bkrajendra/sonpakharu/hardware/sonpakharub.png

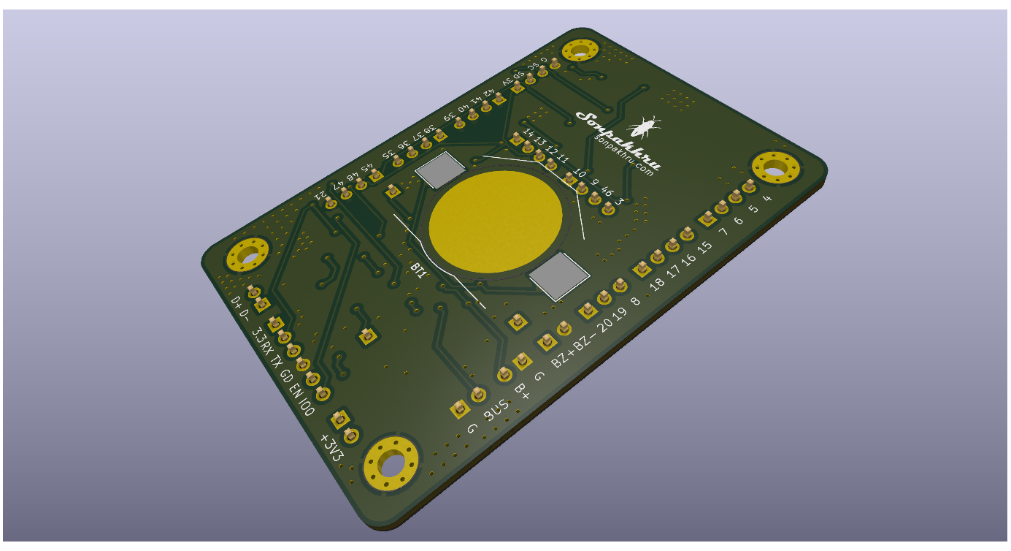
hardware/sonpakharub.png
