bkrajendra/sonpakharu/docs/sonpakharu.png

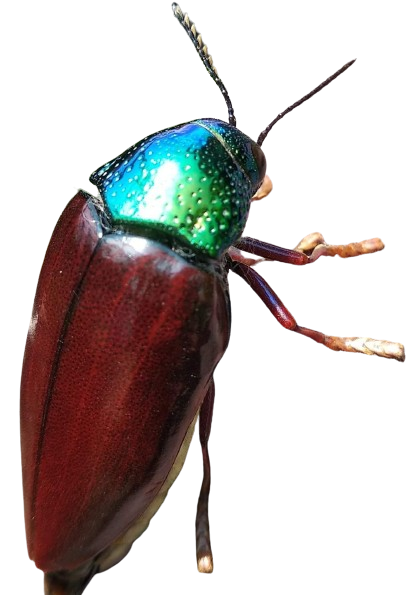
docs/sonpakharu.png
