bkrajendra/sonpakharu/docs/Water_Level_Management_SOP.docx

# Standard Operating Procedure (SOP) – Water Level Management Product

Document Version: 1.0

Date: [17/07/2025]

Purpose: To establish a standardized process for hardware and software development, integration, delivery, and support for the Water Level Management System.

# Hardware Process Flow

## 1. Component Procurement and Payment

- Identify the Bill of Materials (BOM) as per finalized circuit design.
- Source and compare prices from vendors.
- Place order and track shipments.
- Maintain procurement receipts for accounting.
- Confirm delivery checklist.

## 2. Preparation for Assembly

- Prepare and pack all required components for the assembler.
- Provide necessary documents:
- - PCB layout diagram
- - Component placement guide
- - Assembly checklist

## 3. Follow-up with Assembly

- Assign responsible person for communication with assembler.
- Monitor progress on a daily or alternate-day basis.
- Ensure proper ESD-safe practices are followed.

## 4. Validation of Assembled PCB

- Conduct visual inspection for soldering quality.
- Perform continuity and power-on checks.
- Maintain a validation checklist/log.

## 5. Programming for Specific Product

- Flash microcontroller with firmware.
- Use product-specific settings if needed (e.g., sensor calibration, ID tagging).
- Log firmware version and date.

## 6. Testing

- Conduct functional testing using predefined test cases:
- - Sensor readings
- - Communication (e.g., Wi-Fi/LoRa/GSM)
- - Power behavior
- Log results and flag errors for rework.

## 7. Delivery, Provisioning & Installation

- Prepare packaging.
- Install at customer site or deliver with installation manual.
- Configure device based on customer setup.
- Hand over device checklist.

## 8. Support

- Provide basic training to the customer (optional video/manual).
- Offer support window (e.g., 30 days free support).
- Create issue tracking document or ticket system.

# Software Process Flow

## 1. Cloud Setup

- Create cloud instance/project (AWS, GCP, etc.)
- Set up database (e.g., Firebase, MySQL), server, and dashboard.
- Maintain project credentials securely.

## 2. Integration and Testing with Product

- Ensure secure communication protocol (MQTT/HTTPS).
- Test real-time data transmission.
- Simulate multiple scenarios (no internet, power cut, etc.)

## 3. Configuration per Customer

- Setup dashboards as per customer requirements (e.g., tank name, location).
- Set alerts (SMS/email/thresholds).
- Document configuration settings.

## 4. Delivery and Installation

- Share dashboard access credentials with the customer.
- Assist with any browser/mobile setup if required.
- Provide user manual for dashboard navigation.

## 5. Support

- Provide hotline or ticket-based support system.
- Monitor uptime and health of cloud infrastructure.
- Provide monthly performance reports (optional).

# Future Standardization Notes

- Convert this into a Notion / Google Docs template for every project.
- Create checklists in task managers (ClickUp, Trello, Asana).
- Introduce QA forms for hardware and software testing.
- Create video SOPs for training new team members.
