bkrajendra/sonpakharu/hardware/sonpakharu.png

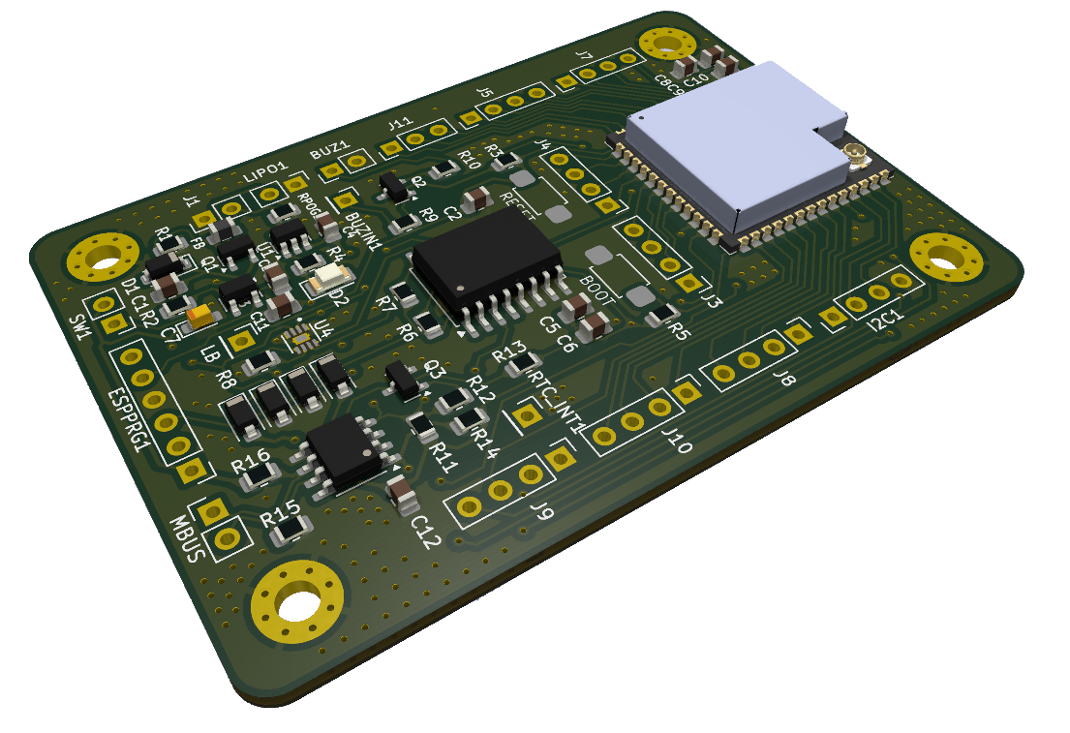
hardware/sonpakharu.png
