bkrajendra/sonpakharu/hardware/bom/bom_template_nextpcb.xls

Designator* | Quantity* | Manufacturer Part Number* | Manufacturer | Package/Footprint | Description | Procurement Type | Customer Note
C1,C2,C10,C11,C12 | 5 | CL21B105KBFNNNE |  | Capacitor_SMD:C_0805_2012Metric | 1uF
C3 | 1 | 0805B471K500NT |  | Capacitor_SMD:C_0805_2012Metric | 470pf
C4,C5 | 2 | CL21A106KAYNNNE |  | Capacitor_SMD:C_0805_2012Metric | 10uf | DNP
C6 | 1 | CC0805KRX7R9BB104 |  | Capacitor_SMD:C_0805_2012Metric | 0.1uf | C
C7 | 1 | T491A225K016AT |  | Capacitor_Tantalum_SMD:CP_EIA-2012-12_Kemet-R_Pad1.30x1.05mm_HandSolder | 2.2uf
C8,C9 | 2 | CL21A106KAYNNNE |  | Capacitor_SMD:C_0805_2012Metric | 10uF
D1,D3,D4,D5,D6 | 5 | LMBR0540T1G |  | Diode_SMD:D_SOD-123 | MBR0540
D2 | 1 | XL-3216SURC |  | LED_SMD:LED_1206_3216Metric | Charging
FB1 | 1 | BLM21PG600SN1D |  | Inductor_SMD:L_0805_2012Metric | FerriteBead
IC1 | 1 | ESP32-S3-WROOM-1U-N16R8 |  | KiCad:ESP32S3WROOM1UN4 | ESP32-S3-WROOM-1U-N4
Q1 | 1 | PMV32UP |  | Package_TO_SOT_SMD:SOT-23 | PMV32UP
Q2,Q3 | 2 | BC847B,215 |  | Package_TO_SOT_SMD:SOT-23 | BC847
R1 | 1 | 0805W8F1003T5E |  | Resistor_SMD:R_0805_2012Metric | 100K
R2 | 1 | 0805W8F0000T5E |  | Resistor_SMD:R_0805_2012Metric | 0
R3,R5,R6,R7,R8,R11,R12,R13,R14 | 9 | 0805W8F1002T5E |  | Resistor_SMD:R_0805_2012Metric | 10k
R4 | 1 | 0805W8F5101T5E |  | Resistor_SMD:R_0805_2012Metric | 5.1K
R9 | 1 | 0805W8F3901T5E |  | Resistor_SMD:R_0805_2012Metric | 3k9
R10 | 1 | 0805W8F100JT5E |  | Resistor_SMD:R_0805_2012Metric | 10E
R15,R16 | 2 | 0805W8F2002T5E |  | Resistor_SMD:R_0805_2012Metric | 20K
RPOG1 | 1 | 0805W8F1001T5E |  | Resistor_SMD:R_0805_2012Metric | 1k
U1 | 1 | MCP73831T-2ACI/OT |  | Package_TO_SOT_SMD:SOT-23-5 | MCP73831-2-OT
U2 | 1 | DS3231M+TRL |  | Package_SO:SOIC-16W_7.5x10.3mm_P1.27mm | DS3231M
U3 | 1 | MIC5219-3.3YM5-TR |  | Package_TO_SOT_SMD:SOT-23-5 | MIC5219-3.3YM5
U4 | 1 | MAX17048G+T10 |  | MAX17048G_T10:SON50P200X200X80-9N | MAX17048G_T10
U5 | 1 | MAX485ESA+T |  | Package_SO:SOIC-8_3.9x4.9mm_P1.27mm | MAX485E
