bkrajendra/sonpakharu/hardware/production/bom.csv

Designator | Footprint | Quantity | Value | LCSC Part #
BOOT1 | TACTILE SWITCH 3X4X2MM SMD | 1 | Boot
BT1 | BatteryHolder_Keystone_3002_1x2032 | 1 | Battery_Cell
BUZ1 | PinHeader_1x02_P2.54mm_Vertical | 1 | Conn_01x02
BUZIN1 | PinHeader_1x01_P2.54mm_Vertical | 1 | Conn_01x01
C1 | 0805 | 1 | 1uF | C5137578
C10, C11, C12, C2 | 0805 | 4 | 1uF | C363560
C3 | 0805 | 1 | 470pf
C4, C5 | 0805 | 2 | 10uf
C6 | 0805 | 1 | 0.1uf
C7 | CP_EIA-2012-12_Kemet-R_Pad1.30x1.05mm_HandSolder | 1 | 2.2uf
C8, C9 | 0805 | 2 | 10uF | C5137578
D1, D3, D4, D5, D6 | D_SOD-123 | 5 | MBR0540 | C116159
D2 | 1206 | 1 | Charging | C779453
ESPPRG1 | PinHeader_1x06_P2.54mm_Vertical | 1 | ESP PRG
FB | 0805 | 1 | FerriteBead
I2C1 | PinHeader_1x04_P2.54mm_Vertical | 1 | I2C
IC1 | ESP32S3WROOM1UN4 | 1 | ESP32-S3-WROOM-1U-N4 | C3013945
J1 | PinHeader_1x02_P2.54mm_Vertical | 1 | PWR
J10 | PinHeader_1x04_P2.54mm_Vertical | 1 | EXT7
J11 | PinHeader_1x03_P2.54mm_Vertical | 1 | EXT3
J3 | PinHeader_1x04_P2.54mm_Vertical | 1 | EXT4
J4 | PinHeader_1x04_P2.54mm_Vertical | 1 | EXT5
J5 | PinHeader_1x04_P2.54mm_Vertical | 1 | EXT2
J7 | PinHeader_1x04_P2.54mm_Vertical | 1 | EXT1
J8 | PinHeader_1x04_P2.54mm_Vertical | 1 | EXT8
J9 | PinHeader_1x04_P2.54mm_Vertical | 1 | EXT6
LB | PinHeader_1x01_P2.54mm_Vertical | 1 | LOWBAT
LIPO1 | PinHeader_1x02_P2.54mm_Vertical | 1 | BATT
MBUS | PinHeader_1x02_P2.54mm_Vertical | 1 | 485
Q1 | SOT-23 | 1 | PMV32UP | C96616
Q2, Q3 | SOT-23 | 2 | BC847
R1 | 0805 | 1 | 100K
R10 | 0805 | 1 | 10E
R11, R12, R13, R14, R3, R5, R6, R7, R8 | 0805 | 9 | 10k
R15, R16 | 0805 | 2 | 20K
R2 | 0805 | 1 | 0
R4 | 0805 | 1 | 5.1K
R9 | 0805 | 1 | 3k9
RESET1 | TACTILE SWITCH 3X4X2MM SMD | 1 | Reset
RPOG1 | 0805 | 1 | 1k
RTC_INT1 | PinHeader_1x01_P2.54mm_Vertical | 1 | INT
SW1 | PinHeader_1x02_P2.54mm_Vertical | 1 | ON/OFF
U1 | SOT-23-5 | 1 | MCP73831-2-OT | C424093
U2 | SOIC-16W_7.5x10.3mm_P1.27mm | 1 | DS3231M
U3 | SOT-23-5 | 1 | MIC5219-3.3YM5
U4 | SON50P200X200X80-9N | 1 | MAX17048G_T10
U5 | SOIC-8_3.9x4.9mm_P1.27mm | 1 | MAX485E | C19738
