bkrajendra/sonpakharu/hardware/production/bom.xlsx

Designator | Footprint | Quantity | Value | LCSC Part #
C1, C2, C3, C4, C5 | 805 | 5 | 10uF | C5137578
C10, C11, C6, C8 | 805 | 4 | 1uF | C363560
D1, D3, D4, D5, D6 | D_SOD-123 | 5 | MBR0540 | C116159
D2 | 1206 | 1 | orange | C779453
IC1 | ESP32S3WROOM1UN4 | 1 | ESP32-S3-WROOM-1U-N4 | C3013945
Q1 | SOT-23 | 1 | DMG3415U | C96616
Q4 | SOT-23 | 1 | S8050 | C5249674
R1, R2 | 805 | 2 | 100K | C25803
R10, R13 | 805 | 2 | 20K | C25804
R12, R14, R15, R16, R5, R7, R8, R9 | 805 | 8 | 10K | C25804
R3, R4 | 805 | 2 | 5.1K | C23186
Reset1 | tactile_5.4 | 1 | Reset
U1 | SOT25 | 1 | AP2112K-3.3TRG1 | C51118
U2 | SOT-23-5 | 1 | MCP73831-2-OT | C424093
U3 | SOIC-8_3.9x4.9mm_P1.27mm | 1 | MCP3426Axx-xSN
U4 | SOIC-8_3.9x4.9mm_P1.27mm | 1 | MAX485E | C19738
