bkrajendra/sonpakharu/hardware/sonpakharu.step

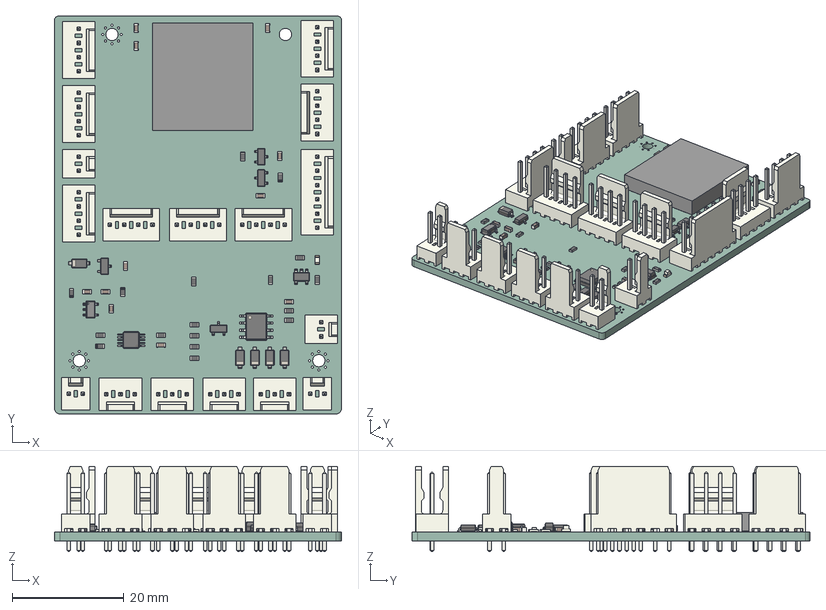
[picture p4: CAD file, 2024-04-07]
hardware/sonpakharu.step
51.3 x 71.1 x 15.3 mm
Molex_AE_6410_02A x 4
D_SOD_123 x 5
Molex_AE_6410_04A x 8
C_0603_1608Metric x 11
SOT_23 x 4
SOIC_8_39x49mm_P127mm
R_0603_1608Metric x 17
Molex_AE_6410_03A x 4
ASSEMBLY
AP2112K-3.3TRG1
VSSOP_10_3x3mm_P05mm
Molex_AE_6410_06A
SOT_23_5
LED_0603_1608Metric
sonpakharu_PCB
