bkrajendra/sonpakharu/docs/best-schematic.pdf

# 3.3V KMR²

# GNDRED

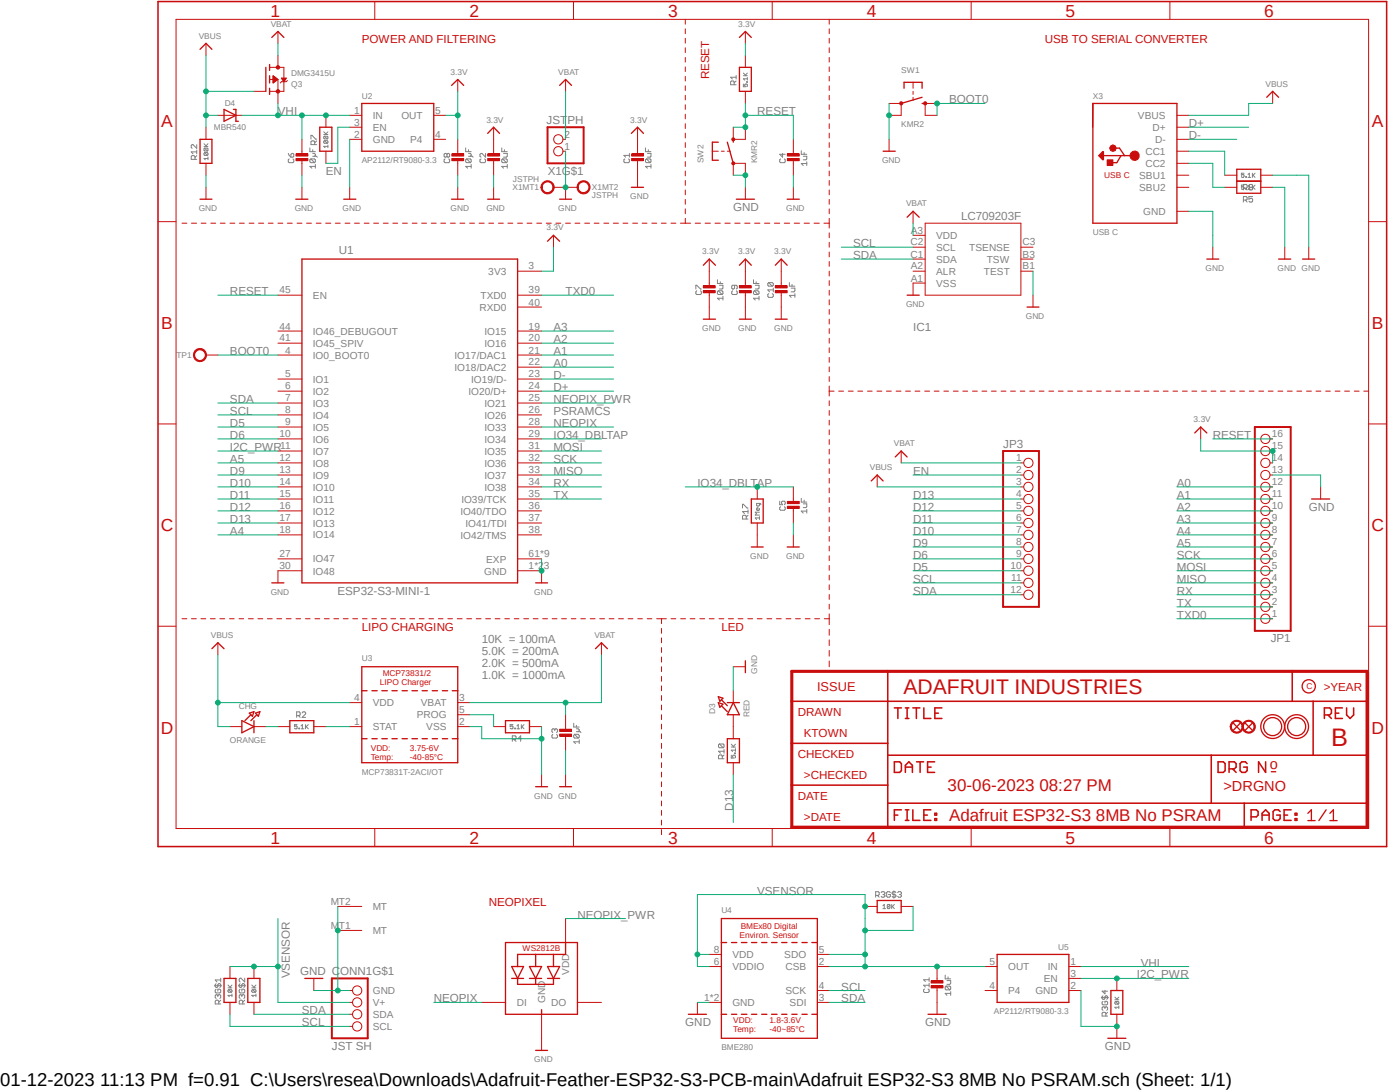
[picture p5: page 1]

VBAT

01-12-2023 11:13 PM f=0.91 C:\Users\resea\Downloads\Adafruit-Feather-ESP32-S3-PCB-main\Adafruit ESP32-S3 8MB No PSRAM.sch (Sheet: 1/1)
