bkrajendra/sonpakharu/docs/schematic.pdf

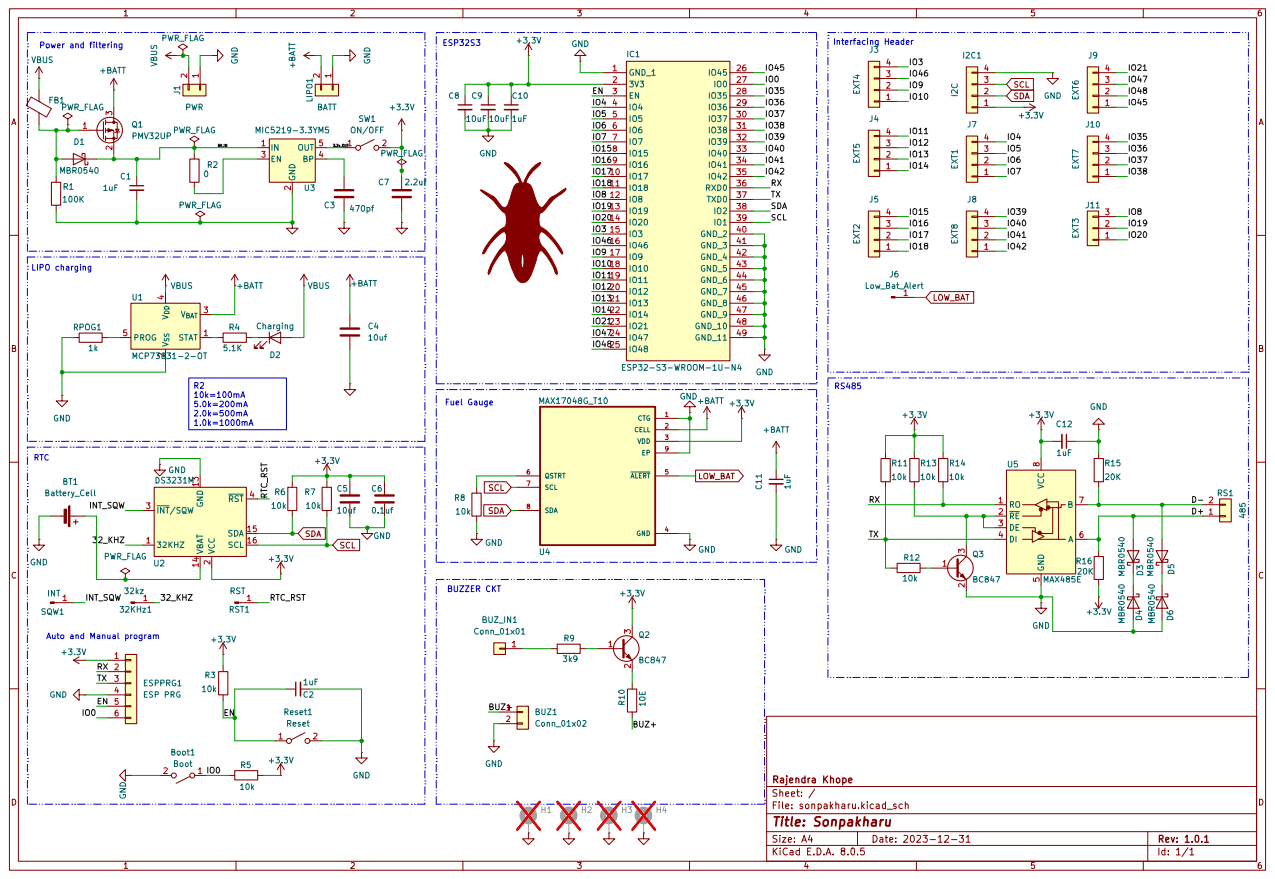
[picture p6: page 1]
