bkrajendra/sonpakharu/hardware/sonpakharu.kicad_pcb

## KiCad design hardware/sonpakharu.kicad_pcb (2025-07-19)

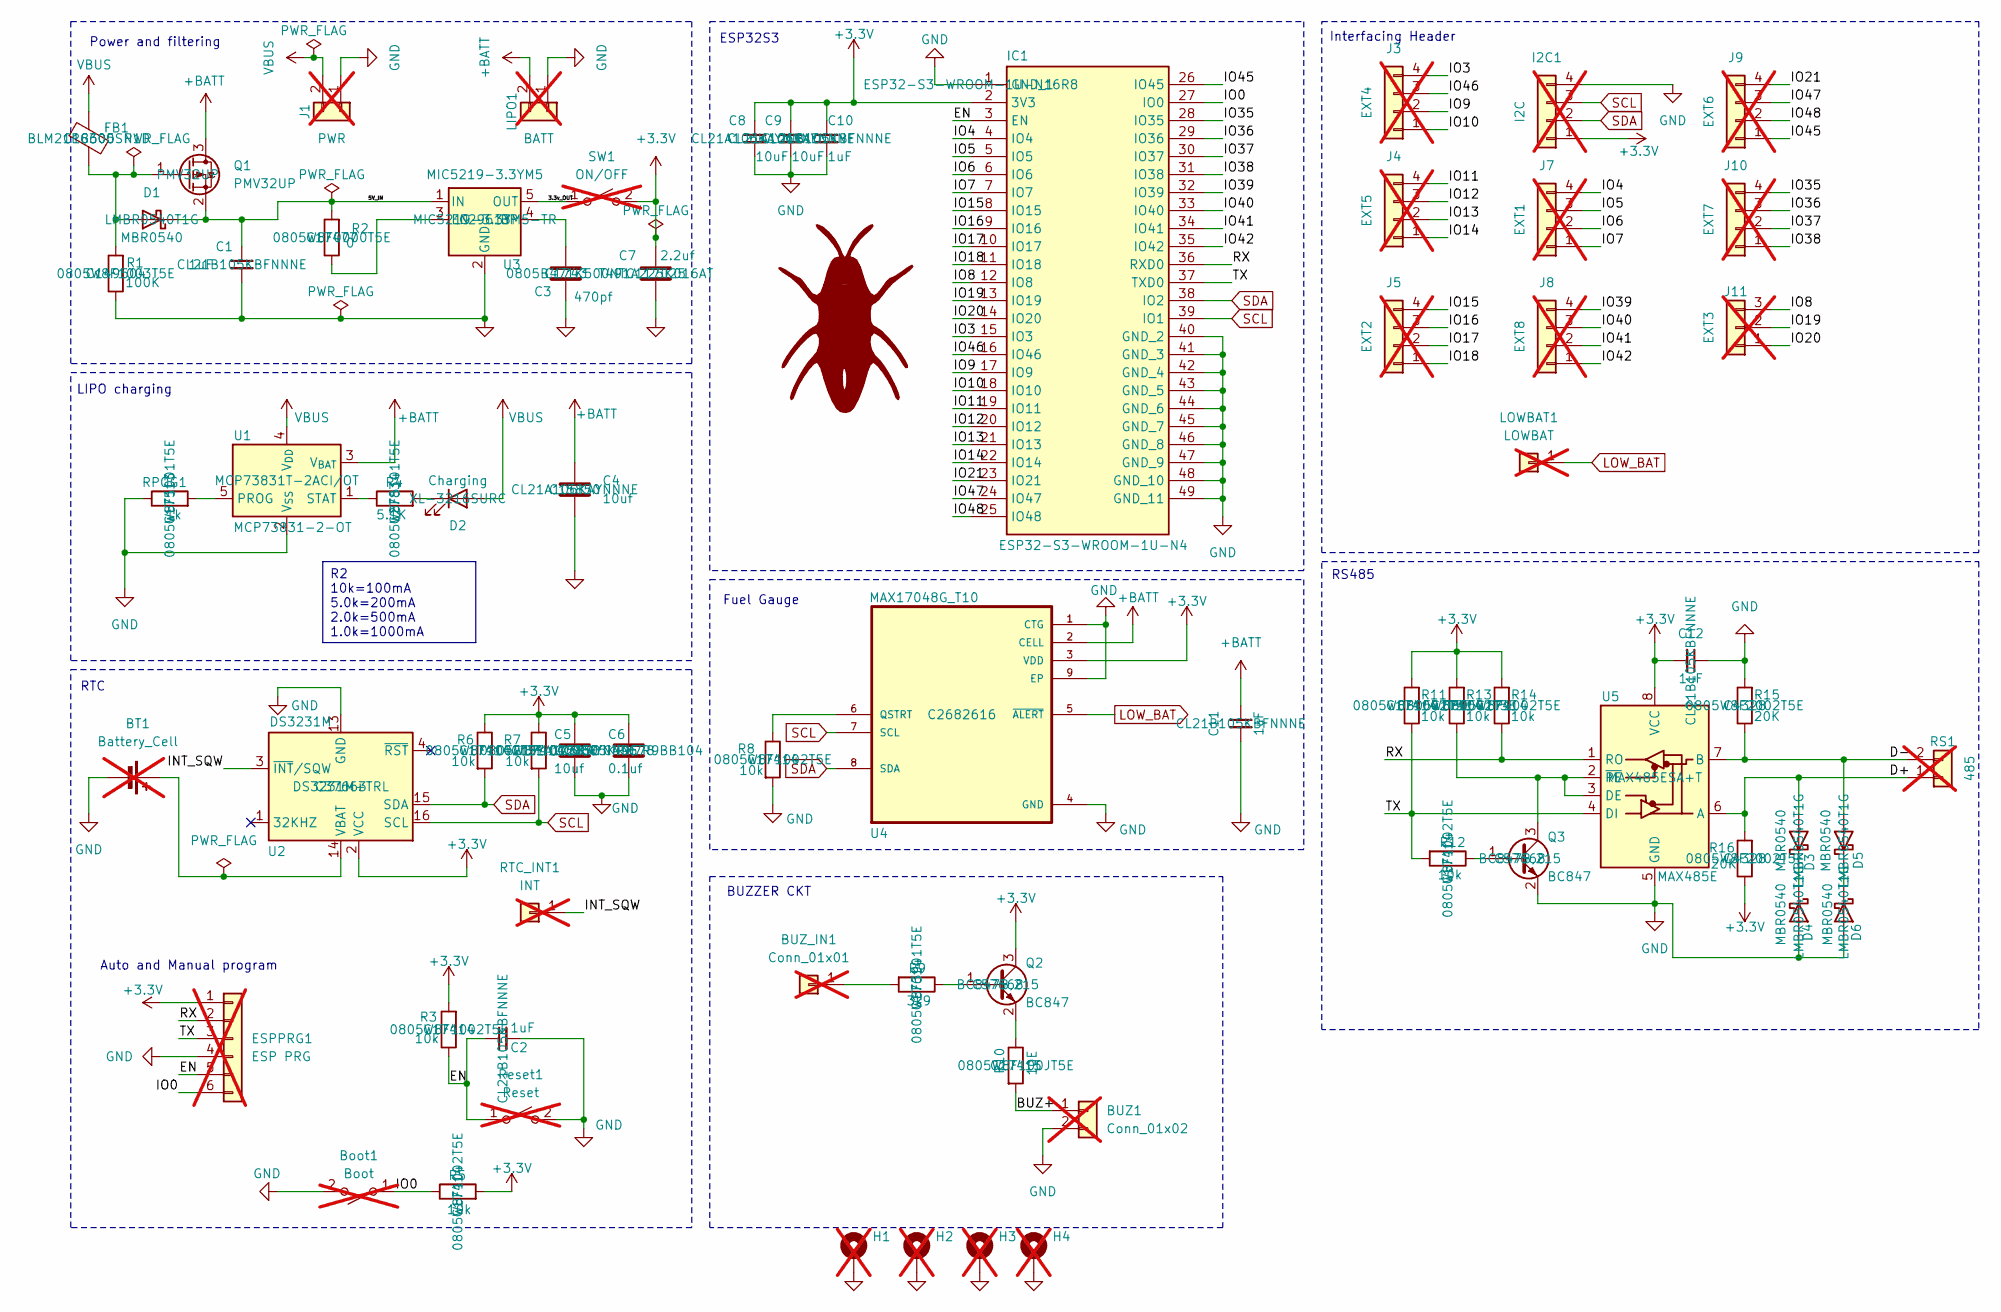
[picture p7: schematic sonpakharu.kicad_sch]

Parts:
BT1: Battery_Cell; BatteryHolder_Keystone_3002_1x2032; not fitted
BUZ1: Conn_01x02; PinHeader_1x02_P2.54mm_Vertical; not fitted
BUZ_IN1: Conn_01x01; PinHeader_1x01_P2.54mm_Vertical; not fitted
Boot1: Boot; TACTILE SWITCH 3X4X2MM SMD; not fitted
C1, C2, C10, C11, C12: 1uF; C_0805_2012Metric; MPN C28323
C3: 470pf; C_0805_2012Metric; MPN C1743
C4, C5: 10uf; C_0805_2012Metric; MPN C15850
C6: 0.1uf; C_0805_2012Metric; MPN C49678
C7: 2.2uf; CP_EIA-2012-12_Kemet-R_Pad1.30x1.05mm_HandSolder; MPN C117025
C8, C9: 10uF; C_0805_2012Metric; MPN C15850
D1, D3, D4, D5, D6: MBR0540; D_SOD-123; MPN C78545
D2: Charging; LED_1206_3216Metric; MPN C965822
ESPPRG1: ESP PRG; PinHeader_1x06_P2.54mm_Vertical; not fitted
FB1: FerriteBead; L_0805_2012Metric; MPN C18305
H1, H2, H4: MountingHole_Pad; MountingHole_3mm_Pad_Via; not fitted
H3: mounting hole; MountingHole_3mm_Pad_Via; not fitted
I2C1: I2C; PinHeader_1x04_P2.54mm_Vertical; not fitted
IC1: ESP32-S3-WROOM-1U-N4; ESP32S3WROOM1UN4; Manufacturer_Part_Number ESP32-S3-WROOM-1U-N4; Mouser Part Number 356-ESP32S3WROOM1UN4
J1: PWR; PinHeader_1x02_P2.54mm_Vertical; not fitted
J3: EXT4; PinHeader_1x04_P2.54mm_Vertical; not fitted
J4: EXT5; PinHeader_1x04_P2.54mm_Vertical; not fitted
J5: EXT2; PinHeader_1x04_P2.54mm_Vertical; not fitted
J7: EXT1; PinHeader_1x04_P2.54mm_Vertical; not fitted
J8: EXT8; PinHeader_1x04_P2.54mm_Vertical; not fitted
J9: EXT6; PinHeader_1x04_P2.54mm_Vertical; not fitted
J10: EXT7; PinHeader_1x04_P2.54mm_Vertical; not fitted
J11: EXT3; PinHeader_1x03_P2.54mm_Vertical; not fitted
LIPO1: BATT; PinHeader_1x02_P2.54mm_Vertical; not fitted
LOWBAT1: LOWBAT; PinHeader_1x01_P2.54mm_Vertical; not fitted
Q1: PMV32UP; SOT-23; MPN C2959851
Q2, Q3: BC847; SOT-23; MPN C57668
R1: 100K; R_0805_2012Metric; MPN C149504
R2: 0; R_0805_2012Metric; MPN C17477
R3, R5, R6, R7, R8, R11, R12, R13, R14: 10k; R_0805_2012Metric; MPN C17414
R4: 5.1K; R_0805_2012Metric; MPN C27834
R9: 3k9; R_0805_2012Metric; MPN C17614
R10: 10E; R_0805_2012Metric; MPN C17415
R15, R16: 20K; R_0805_2012Metric; MPN C4328
RPOG1: 1k; R_0805_2012Metric; MPN C17513
RS1: 485; PinHeader_1x02_P2.54mm_Vertical; not fitted
RTC_INT1: INT; PinHeader_1x01_P2.54mm_Vertical; not fitted
Reset1: Reset; TACTILE SWITCH 3X4X2MM SMD; not fitted
SW1: ON/OFF; PinHeader_1x02_P2.54mm_Vertical; not fitted
U1: MCP73831-2-OT; SOT-23-5; MPN C424093
U2: DS3231M; SOIC-16W_7.5x10.3mm_P1.27mm; MPN C37663
U3: MIC5219-3.3YM5; SOT-23-5; MPN C29613
U4: MAX17048G_T10; SON50P200X200X80-9N; MPN C2682616
U5: MAX485E; SOIC-8_3.9x4.9mm_P1.27mm; MPN C19738

Connections:
+3.3V: C5.1, C6.1, C7.1, C8.1, C9.1, C10.1, C12.2, ESPPRG1.1, I2C1.1, IC1.2 (3V3), Q2.3 (C), R3.2, R5.2, R6.1, R7.1, R11.2, R13.2, R14.2, R16.1, SW1.2 (B), U2.2 (VCC), U4.3 (VDD), U5.8 (VCC)
+BATT: C4.1, C11.1, LIPO1.2, Q1.3 (D), U1.3 (V_{BAT}), U4.2 (CELL)
/3.3v_OUT: SW1.1 (A), U3.5 (OUT)
/5V_IN: C1.1, D1.1 (K), Q1.2 (S), R2.2, U3.1 (IN)
/BUZ+: BUZ1.1, R10.2
/D+: D3.2 (A), R16.2, RS1.1, U5.6 (A); also elsewhere on the board
/D-: D5.2 (A), R15.1, RS1.2, U5.7 (B); also elsewhere on the board
/EN: C2.1, ESPPRG1.5, IC1.3 (EN), R3.1, Reset1.1 (A)
/INT_SQW: RTC_INT1.1, U2.3 (~INT/SQW)
/IO0: Boot1.1 (A), ESPPRG1.6, IC1.27 (IO0), R5.1
/IO3: IC1.15 (IO3), J3.4
/IO4: IC1.4 (IO4), J7.4
/IO5: IC1.5 (IO5), J7.3
/IO6: IC1.6 (IO6), J7.2
/IO7: IC1.7 (IO7), J7.1
/IO8: IC1.12 (IO8), J11.3
/IO9: IC1.17 (IO9), J3.2
/IO10: IC1.18 (IO10), J3.1
/IO11: IC1.19 (IO11), J4.4
/IO12: IC1.20 (IO12), J4.3
/IO13: IC1.21 (IO13), J4.2
/IO14: IC1.22 (IO14), J4.1
/IO15: IC1.8 (IO15), J5.4
/IO16: IC1.9 (IO16), J5.3
/IO17: IC1.10 (IO17), J5.2
/IO18: IC1.11 (IO18), J5.1
/IO19: IC1.13 (IO19), J11.2
/IO20: IC1.14 (IO20), J11.1
/IO21: IC1.23 (IO21), J9.4
/IO35: IC1.28 (IO35), J10.4
/IO36: IC1.29 (IO36), J10.3
/IO37: IC1.30 (IO37), J10.2
/IO38: IC1.31 (IO38), J10.1
/IO39: IC1.32 (IO39), J8.4
/IO40: IC1.33 (IO40), J8.3
/IO41: IC1.34 (IO41), J8.2
/IO42: IC1.35 (IO42), J8.1
/IO45: IC1.26 (IO45), J9.1
/IO46: IC1.16 (IO46), J3.3
/IO47: IC1.24 (IO47), J9.3
/IO48: IC1.25 (IO48), J9.2
/RX: ESPPRG1.2, IC1.36 (RXD0), R14.1, U5.1 (RO)
/TX: ESPPRG1.3, IC1.37 (TXD0), R11.1, R12.2, U5.4 (DI)
GND: BT1.2 (-), BUZ1.2, Boot1.2 (B), C1.2, C2.2, C3.2, C4.2, C5.2, C6.2, C7.2, C8.2, C9.2, C10.2, C11.2, C12.1, D4.2 (A), D6.2 (A), ESPPRG1.4, H1.1, H2.1, H3.1, H4.1, I2C1.4, IC1.1 (GND_1), IC1.40 (GND_2), IC1.41 (GND_3), IC1.42 (GND_4), IC1.43 (GND_5), IC1.44 (GND_6), IC1.45 (GND_7), IC1.46 (GND_8), IC1.47 (GND_9), IC1.48 (GND_10), IC1.49 (GND_11), J1.1, LIPO1.1, Q3.2 (E), R1.1, R8.2, R15.2, RPOG1.1, Reset1.2 (B), U1.2 (V_{SS}), U2.5 (GND), U2.6 (GND), U2.7 (GND), U2.8 (GND), U2.9 (GND), U2.10 (GND), U2.11 (GND), U2.12 (GND), U2.13 (GND), U3.2 (GND), U4.1 (CTG), U4.4 (GND), U4.9 (EP), U5.5 (GND)
LOW_BAT: LOWBAT1.1, U4.5 (~ALERT); also elsewhere on the board
unnamed: BT1.1 (+), U2.14 (VBAT)
unnamed 46: BUZ_IN1.1, R9.2; also elsewhere on the board
unnamed 47: D1.2 (A), FB1.2, Q1.1 (G), R1.2; also elsewhere on the board
unnamed: D2.1 (K), R4.2
unnamed: D3.1 (K), D4.1 (K)
unnamed: D5.1 (K), D6.1 (K)
unnamed: Q2.1 (B), R9.1
unnamed: Q2.2 (E), R10.1
unnamed: Q3.1 (B), R12.1
unnamed: Q3.3 (C), R13.1, U5.2 (~RE), U5.3 (DE)
unnamed: RPOG1.2, U1.5 (PROG)
unnamed: R4.1, U1.1 (STAT)
unnamed: C3.1, U3.4 (BP)
unnamed: R2.1, U3.3 (EN)
unnamed: R8.1, U4.6 (QSTRT)
SCL: I2C1.3, IC1.39 (IO1), R7.2, U2.16 (SCL), U4.7 (SCL)
SDA: I2C1.2, IC1.38 (IO2), R6.2, U2.15 (SDA), U4.8 (SDA)
VBUS: D2.2 (A), FB1.1, J1.2, U1.4 (V_{DD}); also elsewhere on the board

Notes on the sheet:
Power and filtering
BUZZER CKT
Auto and Manual program
Fuel Gauge
RS485
RTC
LIPO charging
ESP32S3
Interfacing Header
R2 10k=100mA 5.0k=200mA 2.0k=500mA 1.0k=1000mA

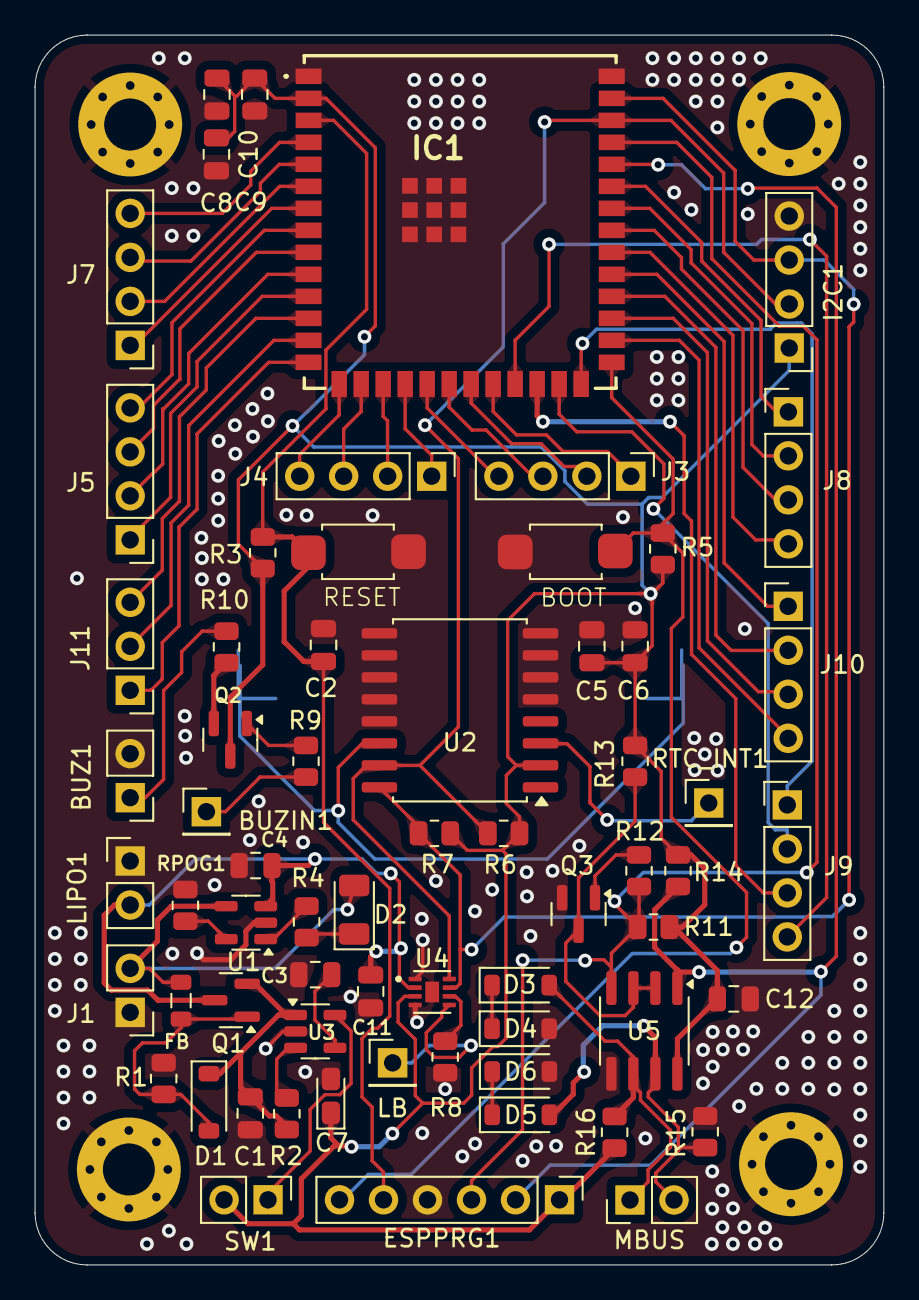
[picture p8: board sonpakharu.kicad_pcb from above]

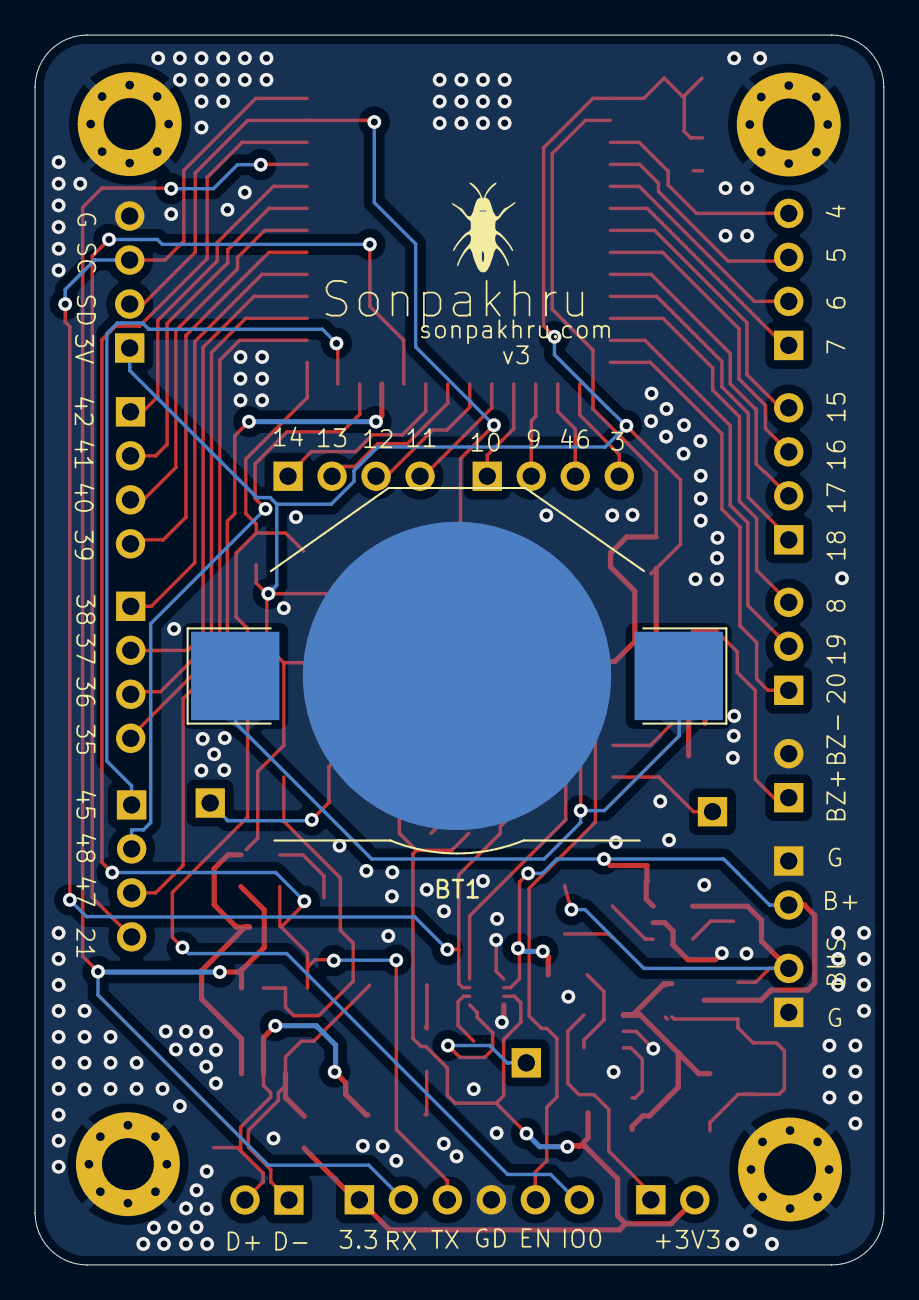
[picture p9: board sonpakharu.kicad_pcb from below]

Board: 2 copper layers, 49.0 x 71.0 mm, 71 parts (2 on the bottom side), 63 nets.

Other parts of the board:
BUZIN1: Conn_01x01; PinHeader_1x01_P2.54mm_Vertical
FB: FerriteBead; L_0805_2012Metric
LB: LOWBAT; PinHeader_1x01_P2.54mm_Vertical
MBUS: 485; PinHeader_1x02_P2.54mm_Vertical
spb: LOGO; sonpakaharu

Their connections:
/D+: MBUS.1; also elsewhere on the board
/D-: MBUS.2; also elsewhere on the board
LOW_BAT: LB.1; also elsewhere on the board
unnamed 46: BUZIN1.1; also elsewhere on the board
unnamed 47: FB.2; also elsewhere on the board
VBUS: FB.1; also elsewhere on the board
