bkrajendra/sonpakharu/(threads)

Thread 1 (2024-04-07):

Missing Power Switch

bkrajendra, 2024-04-07:
The board do not have a power on off switch
It needs one switch for the last power input to switch ON-OFF battery or supply power off.
Need just a pad, and the switch will be mounted on the case.

gauravbhand85, 2024-04-07:
added switch and normal pin header footprint

gauravbhand85, 2024-04-10:
created custom footprint for the ordered switch. Only needs to verify physically now.

bkrajendra, 2024-08-11:
added header

Closed 2024-08-11.

Thread 2 (2024-04-07):

Board pin map is incorrect.

bkrajendra, 2024-04-07:
Map the board pins correctly
http://wiki.fluidnc.com/en/hardware/ESP32-S3_Pin_Reference
refer: https://docs.espressif.com/projects/esp-idf/en/stable/esp32s3/api-reference/peripherals/gpio.html
https://www.espressif.com/sites/default/files/documentation/esp32-s3_technical_reference_manual_en.pdf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

gauravbhand85, 2024-04-10:
this has been figured out now

gauravbhand85, 2024-04-10:
corrected

Closed 2024-08-11.

Thread 5 (2024-08-11):

Add RTC module on board with battery holder

bkrajendra, 2024-08-11:
Add RTC module on board with battery holder
Suggest RTC chip
DS3231 or DS1307

bkrajendra, 2024-08-11:
https://arduinogetstarted.com/faq/ds3231-vs-ds1307

bkrajendra, 2024-09-02:
done

Closed 2024-09-02.

Thread 6 (2024-08-11):

add buzzer on main board

bkrajendra, 2024-08-11:
add buzzer on main board
3v buzzer - passive.

Thread 8 (2024-09-02):

Arrange pins for shortest path with esp32

bkrajendra, 2024-09-02:
Arrange pins for shortest path with esp32
