bkrajendra/sonpakharu/(commit log)

2023-12-01 Added s3 footprint
    [sonpakharu.kicad_pcb, sonpakharu.kicad_sch]
2023-12-01 Fixed paths
    [sonpakharu.kicad_pcb, sonpakharu.kicad_sch]
2023-12-02 added usb otg
    [sonpakharu.kicad_sch]
2023-12-02 added uart,reset
    [sonpakharu.kicad_sch]
2023-12-02 minor changes
    [sonpakharu.kicad_sch]
2023-12-02 added power and program ckt
    [sonpakharu.kicad_sch]
2023-12-02 added adc
    [sonpakharu.kicad_sch]
2023-12-02 added gpio connectors
    [sonpakharu.kicad_sch]
2023-12-02 added battery connector
    [sonpakharu.kicad_sch]
2023-12-02 main power
    [sonpakharu.kicad_sch]
2023-12-02 khope ka kida
    [sonpakharu.kicad_sch]
2023-12-02 minor change
    [sonpakharu.kicad_sch]
2023-12-03 added main components mpn
    [sonpakharu.kicad_sch]
2024-01-01 Fix: routing
    [bom.csv, designators.csv, positions.csv, sonpakharu.csv, sonpakharu.kicad_pcb, sonpakharu.kicad_sch]
2024-01-01 routing done
    [bom.csv, designators.csv, positions.csv, sonpakharu.kicad_pcb]
2024-01-02 added 485
    [sonpakharu.kicad_sch]
2024-01-02 converted 485 sch to pcb
    [sonpakharu.kicad_pcb]
2024-01-02 component placment done
    [freerouting.dsn, sonpakharu.kicad_pcb, sonpakharu.kicad_sch]
2024-01-02 all routing done, no errors, 3 minor warnings
    [freerouting.dsn, sonpakharu.kicad_pcb]
2024-01-02 corrected placement
    [freerouting.dsn, sonpakharu.kicad_pcb, temp-freerouting.dsn]
2024-01-02 track correction and tactile switch footprint pending
    [sonpakharu.kicad_pcb]
2024-01-03 almost all tracks corrected, added tactile smd
    [sonpakharu.kicad_pcb, sonpakharu.kicad_sch]
2024-01-03 all tracks corrected, 0 errors 0 warnings
    [sonpakharu.kicad_pcb]
2024-01-03 Added: labels
    [bom.csv, designators.csv, freerouting.dsn, positions.csv, sonpakharu.kicad_pcb, temp-freerouting.dsn]
2024-01-03 completed all labels, added mx485 mpn
    [sonpakharu.kicad_pcb, sonpakharu.kicad_sch]
2024-01-03 corrected labels
    [sonpakharu.kicad_pcb]
2024-01-04 added holes
    [sonpakharu.kicad_pcb]
2024-01-07 Fix: added pads, ground vias and logo
    [bom.csv, designators.csv, positions.csv, sonpakharu.kicad_pcb, sonpakharu.kicad_sch]
2024-01-08 updated tactile smd part number
    [bom.csv, designators.csv, positions.csv, sonpakharu.kicad_pcb, sonpakharu.kicad_sch]
2024-02-04 Fix: foot prints, re routed pcb, added 3d model
    [bom.csv, designators.csv, freerouting.dsn, positions.csv, sonpakharu.kicad_pcb, sonpakharu.kicad_sch, temp-freerouting.dsn]
2024-04-07 Fix: final fixes
    [bom.csv, designators.csv, positions.csv, sonpakharu.kicad_pcb, sonpakharu.kicad_sch, sonpakharu.step, sonpakhru.csv, sonpakhru.kicad_pcb]
2024-04-07 Fix cleanup
    [bom.csv, designators.csv, positions.csv, sonpakhru.csv, sonpakhru.kicad_pcb, sonpakhru.kicad_sch]
2024-04-15 rectified sch
    [sonpakharu.kicad_pcb, sonpakharu.kicad_sch]
2024-04-23 deleted unused footprints
    [sonpakharu.kicad_pcb]
2024-05-12 removed auto prg ckt, done routing, touch up pending
    [sonpakharu.kicad_pcb, sonpakharu.kicad_sch]
2024-05-13 corrected signal tracks
    [sonpakharu.kicad_pcb, sonpakharu.kicad_sch]
2024-06-04 rectified sda scl lines
    [sonpakharu.kicad_sch]
2024-06-21 added IO4 pin to connector
    [sonpakharu.kicad_pcb, sonpakharu.kicad_sch]
2024-06-26 rectified labels, all routing done
    [sonpakharu.kicad_pcb]
2024-07-11 Fix: layout u[dated
    [bom.csv, bom.xlsx, designators.csv, positions.csv, sonpakharu.kicad_pcb, sonpakharu.kicad_sch]
2024-08-12 Added: rtc, fuel gauge, fixed placement, charge led and minor fixes
    [sonpakharu.kicad_pcb, sonpakharu.kicad_sch]
2024-08-13 Fix: directory structure chaned
    [main.cpp]
2024-09-09 Fix: removed adc from board, minor chnages
    [freerouting.dsn, sonpakharu.kicad_pcb, sonpakharu.kicad_sch, temp-freerouting.dsn]
2024-09-09 updated sch and components placement
    [sonpakharu.kicad_pcb, sonpakharu.kicad_sch]
2024-09-09 Fix: updated buzzer and board baundary
    [sonpakharu.kicad_pcb, sonpakharu.kicad_sch]
2024-09-10 routing done, tracks to optimize further
    [freerouting.dsn, sonpakharu.kicad_pcb, sonpakharu.kicad_sch, temp-freerouting.dsn]
2024-09-11 most tracks optimized, silkscreen warnings pending
    [sonpakharu.kicad_pcb]
2024-10-14 Rerouted the board
    [sonpakharu.kicad_pcb, sonpakharu.kicad_sch]
